DCC-EX/EX-SensorCAM/(commit log)

2023-10-01 Add files via upload
    Separates CS files from sensorCAM
2024-04-24 Add files via upload
    Added individual threshold option for each sensor using 't##,%%'. Default is global threshold 't##'. Clear with 't00,%%'
2024-05-12 Add files via upload
    includes code to enable block read of 8 sensors via ANIN
2024-06-08 Delete devel/sensorCAM.pde
    moved to process4
2024-09-20 Delete InstallationGuide8.pdf
    Update re Espressif ESP32 v 2.0.17
2025-03-07 Delete sensorCAMmanual3.13.pdf
    superseded
2025-06-08 CAM accepts <N..> CS commands directly.
    Also better bank LED and minSensors functionality
2025-06-08 now accepts <N...> CS style commands
    Also enhanced bank LED operation and minSensors
2025-07-31 updates including i2c check byte
2025-08-28 bug fix and enhancements to replace Prod driver
2025-09-16 Includes ESP32 WROVER CAM option
2025-09-26 Includes info on ESP32-WROVER-CAM
2026-04-16 esp32-S3 update
